hackster254/Water-purifier-LILYGO-Project/WATER PURIFIER LILYGO PCB/12v_5v_IMAGEBACK.png

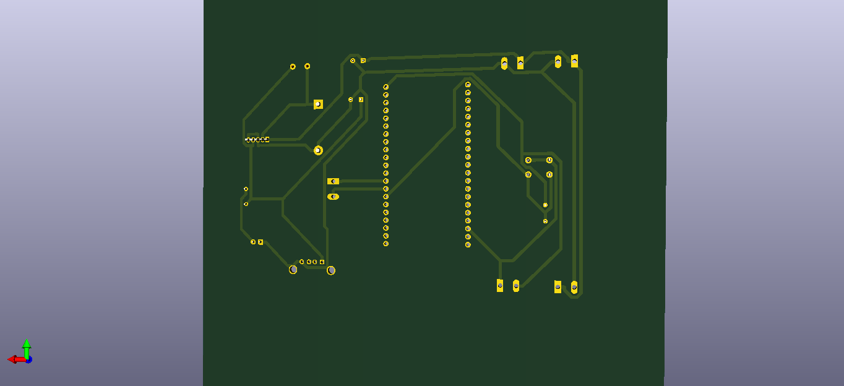
WATER PURIFIER LILYGO PCB/12v_5v_IMAGEBACK.png
