hackster254/Water-purifier-LILYGO-Project/WATER PURIFIER LILYGO PCB/REDITADDEDSCHEMATIC.pdf

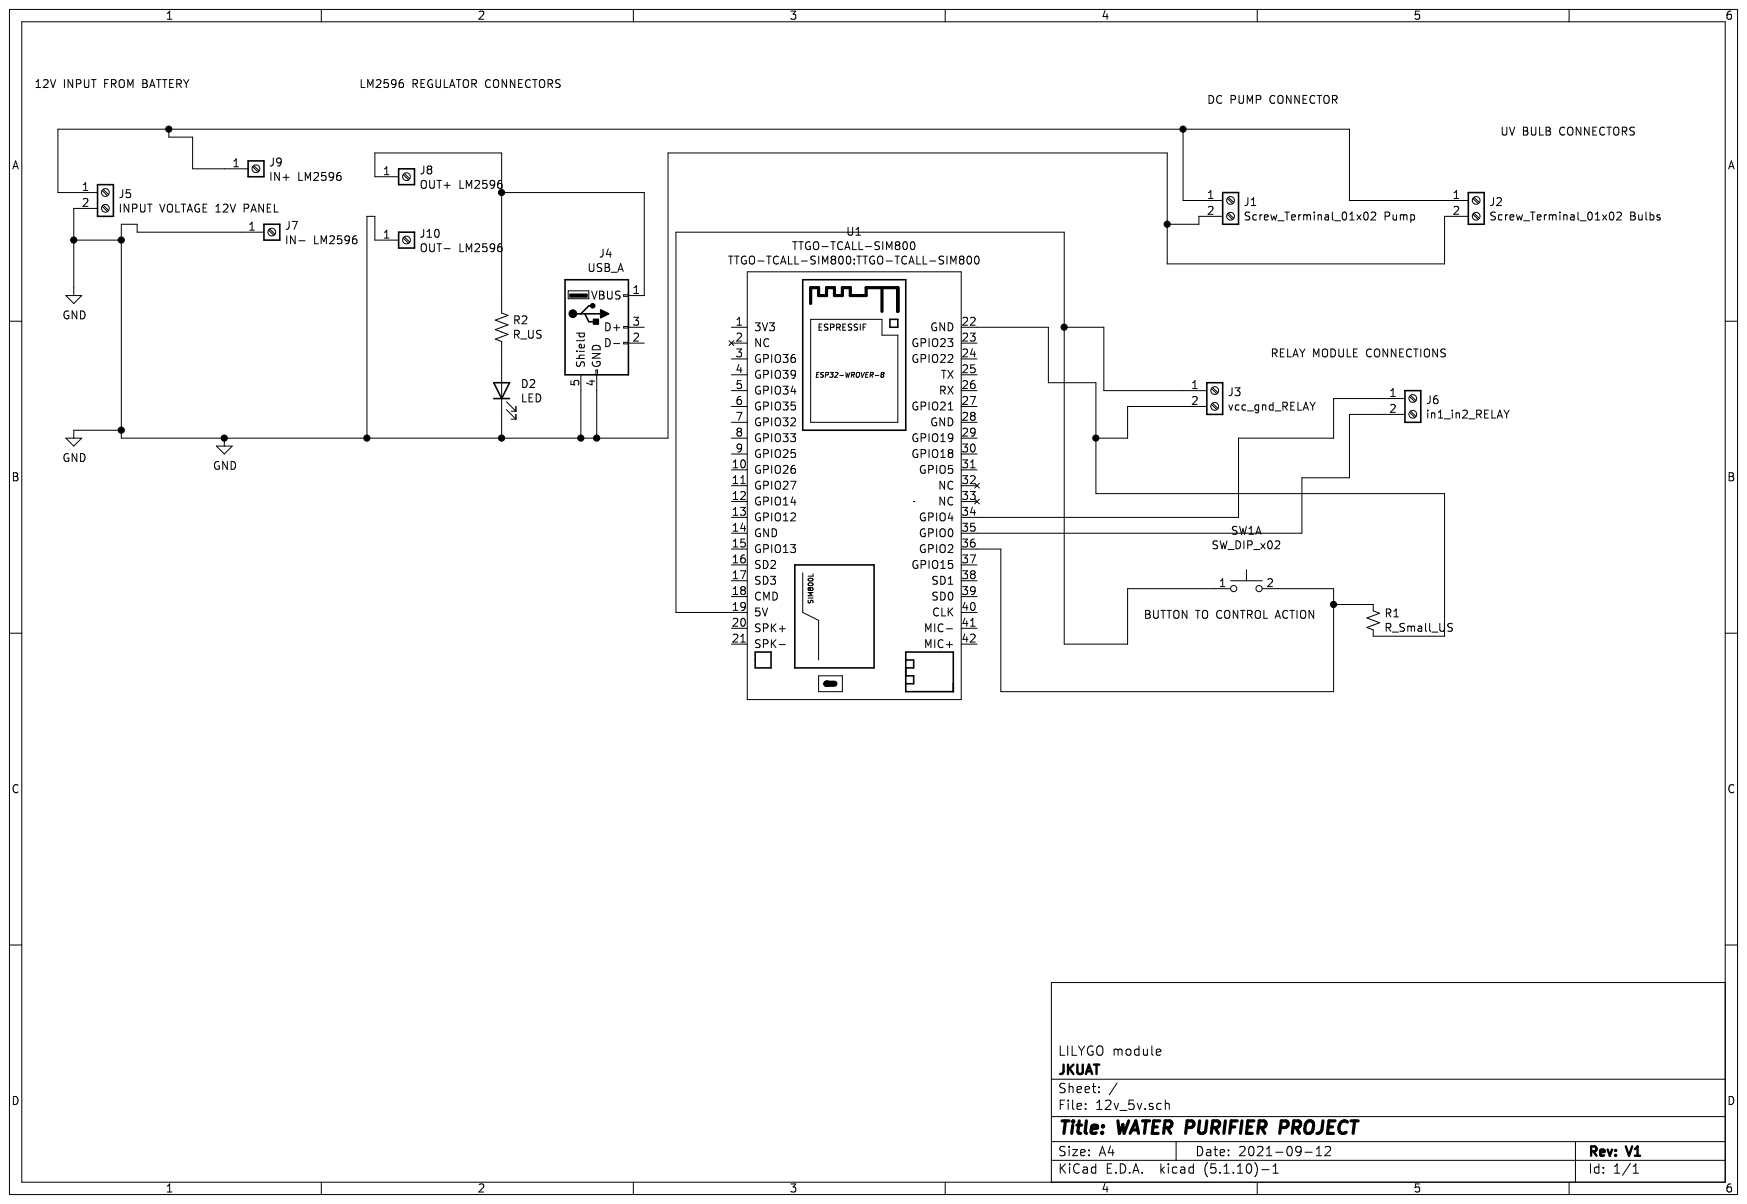
[picture p37: page 1]
