hackster254/Water-purifier-LILYGO-Project/WATER PURIFIER LILYGO PCB/REDITADDEDSINGLEPAGES.pdf

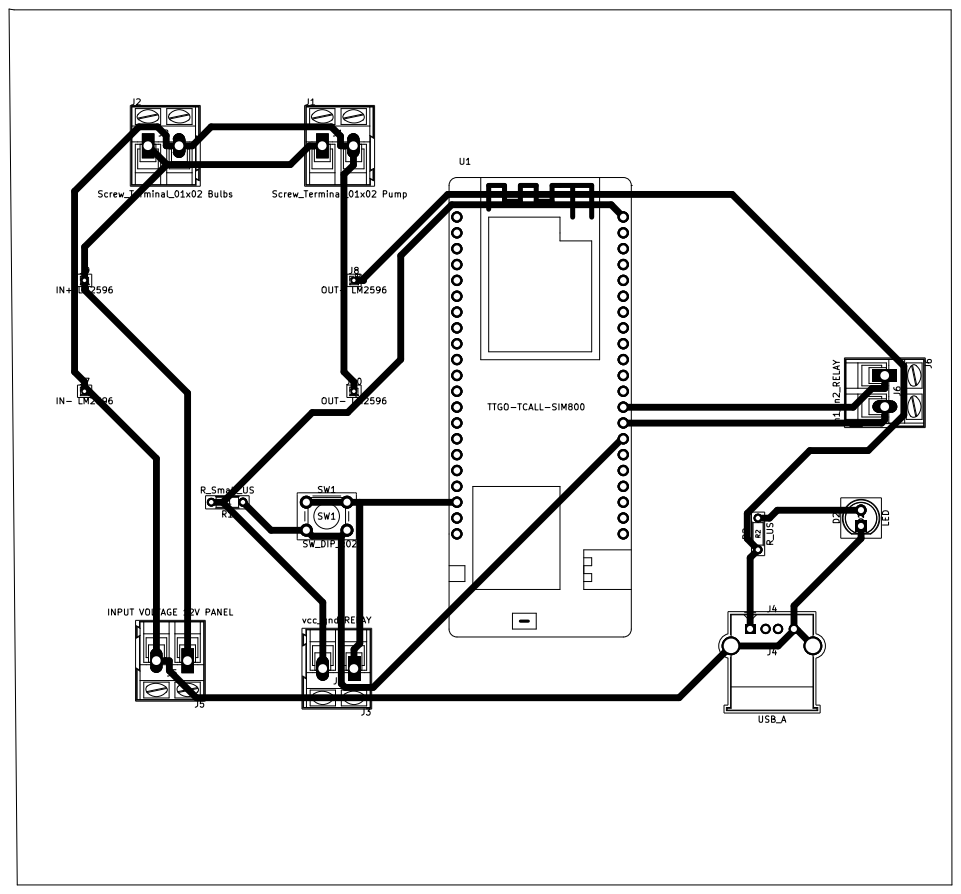
[picture p38: page 1]
