hackster254/Water-purifier-LILYGO-Project/WATER PURIFIER LILYGO PCB/SAM_COMBINEDTRACES.pdf

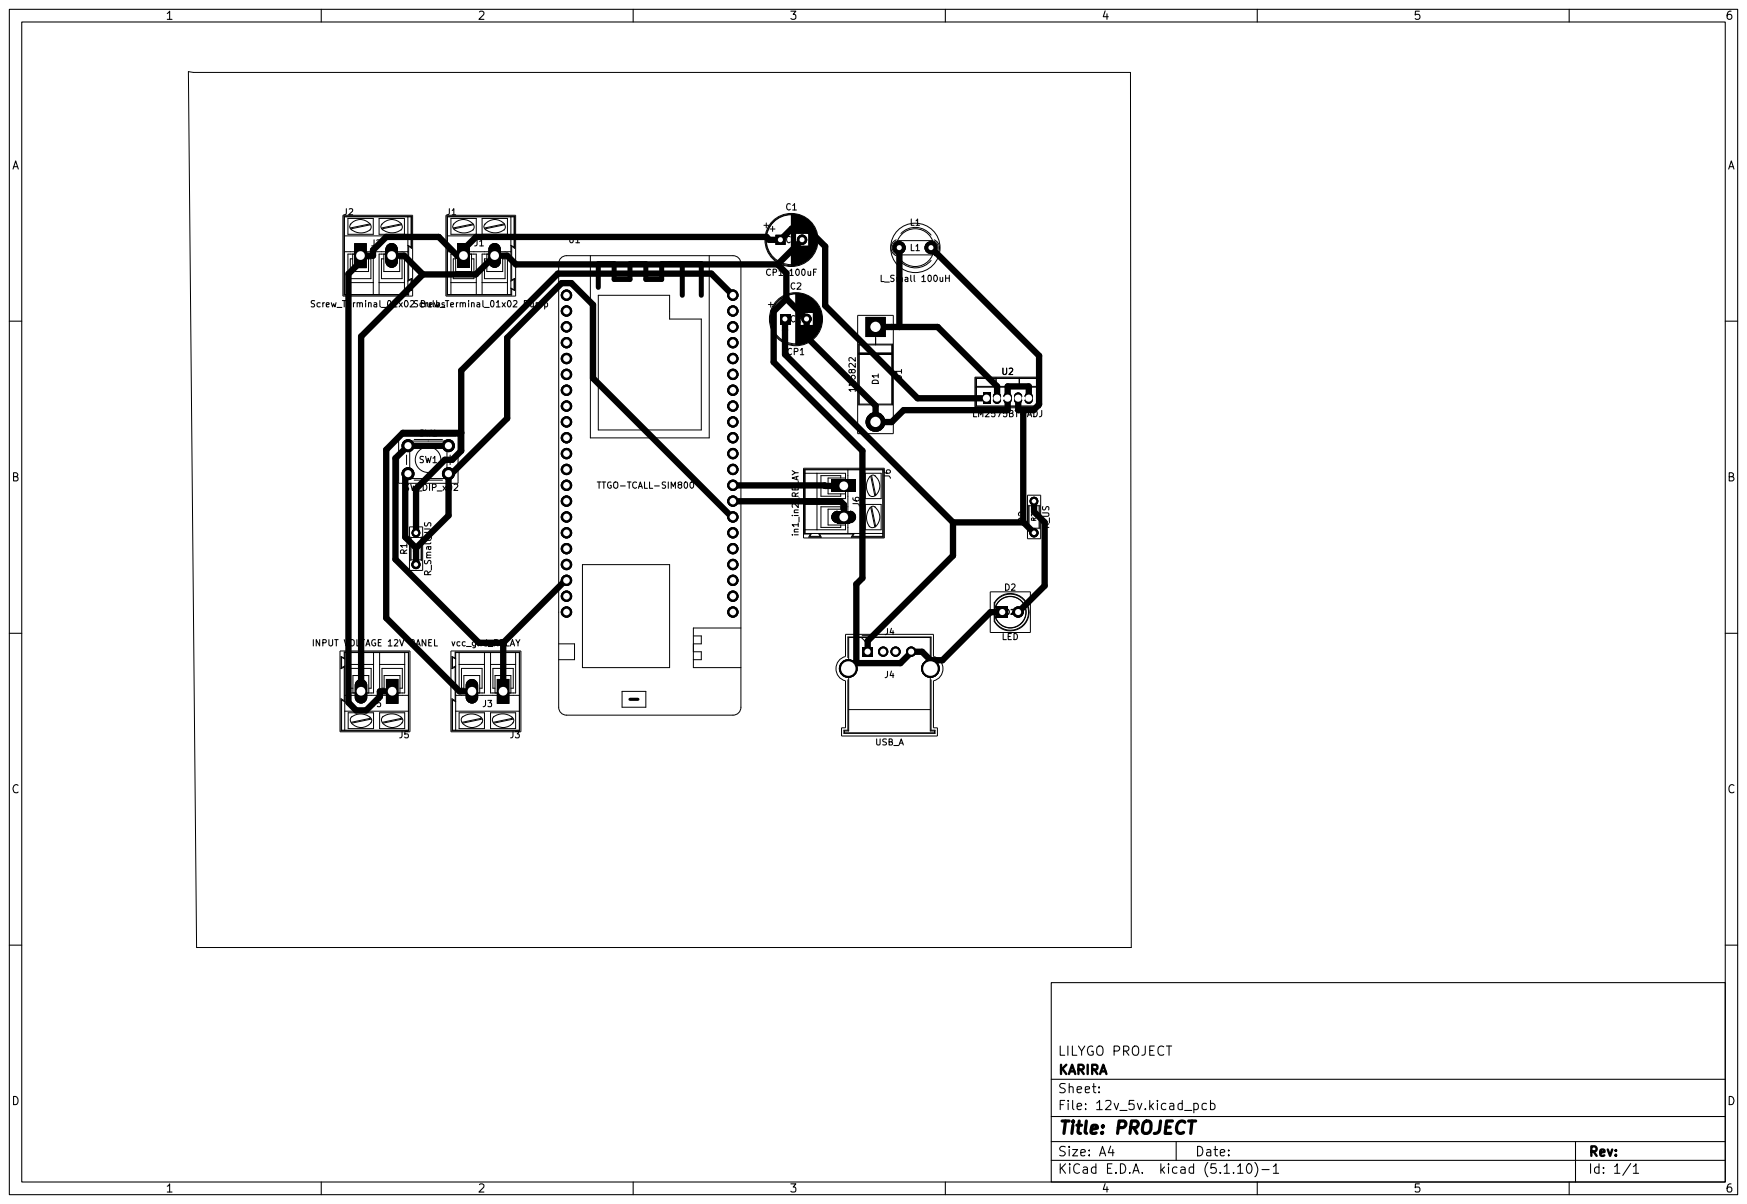
[picture p39: page 1]
