hackster254/Water-purifier-LILYGO-Project/(list of files, drawings)

Other design files:
WATER PURIFIER LILYGO PCB/12v_5v.dsn
WATER PURIFIER LILYGO PCB/12v_5v_EDITEDADDED.dsn
WATER PURIFIER LILYGO PCB/12v_5v_FRIDAY_SAM.dsn
WATER PURIFIER LILYGO PCB/12v_5v_v1.dsn
