hackster254/Water-purifier-LILYGO-Project/WATER PURIFIER LILYGO PCB/12v_5v.kicad_pcb

## KiCad design WATER PURIFIER LILYGO PCB/12v_5v.kicad_pcb (2021-11-19)

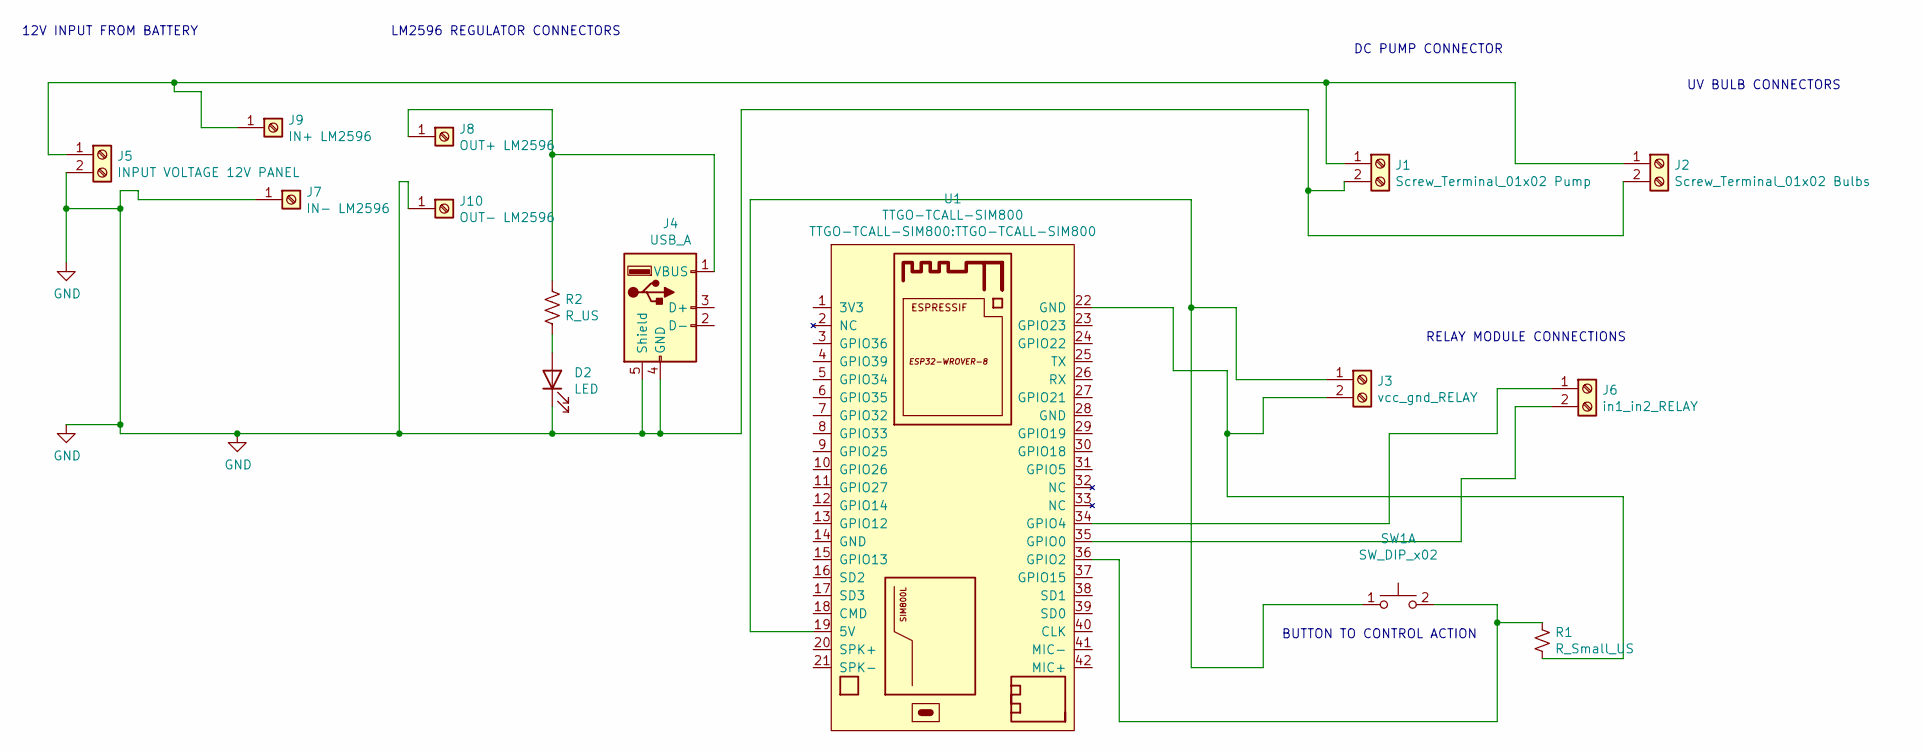
[picture p40: schematic 12v_5v.sch, WATER PURIFIER PROJECT]

Parts:
D2: LED; LED_D5.0mm
J1: Screw_Terminal_01x02 Pump; TerminalBlock_Altech_AK300-2_P5.00mm
J2: Screw_Terminal_01x02 Bulbs; TerminalBlock_Altech_AK300-2_P5.00mm
J3: vcc_gnd_RELAY; TerminalBlock_Altech_AK300-2_P5.00mm
J4: USB_A; USB_A_Molex_67643_Horizontal
J5: INPUT VOLTAGE 12V PANEL; TerminalBlock_Altech_AK300-2_P5.00mm
J6: in1_in2_RELAY; TerminalBlock_Altech_AK300-2_P5.00mm
J7: IN- LM2596; PinHeader_1x01_P1.00mm_Vertical
J8: OUT+ LM2596; PinHeader_1x01_P1.00mm_Vertical
J9: IN+ LM2596; PinHeader_1x01_P1.00mm_Vertical
J10: OUT- LM2596; PinHeader_1x01_P1.00mm_Vertical
R1: R_Small_US; R_Axial_DIN0204_L3.6mm_D1.6mm_P5.08mm_Horizontal
R2: R_US; R_Axial_DIN0204_L3.6mm_D1.6mm_P5.08mm_Horizontal
SW1: SW_DIP_x02; SW_PUSH_6mm_H5mm
U1: TTGO-TCALL-SIM800

Connections:
GND: D2.1 (K), J1.2, J2.2, J4.4 (GND), J4.5 (Shield), J5.2, J7.1, J10.1
unnamed: D2.2 (A), R2.2
unnamed: J1.1, J2.1, J5.1, J9.1
unnamed: J3.1, SW1.1 (C), U1.19 (5V)
unnamed: J3.2, R1.2, U1.22 (GND)
unnamed: J4.1 (VBUS), J8.1, R2.1
unnamed: J6.1, U1.34 (GPIO4)
unnamed: J6.2, U1.35 (GPIO0)
unnamed: R1.1, SW1.2 (D), U1.36 (GPIO2)

Notes on the sheet:
RELAY MODULE CONNECTIONS
UV BULB CONNECTORS
DC PUMP CONNECTOR
12V INPUT FROM BATTERY
BUTTON TO CONTROL ACTION
LM2596 REGULATOR CONNECTORS

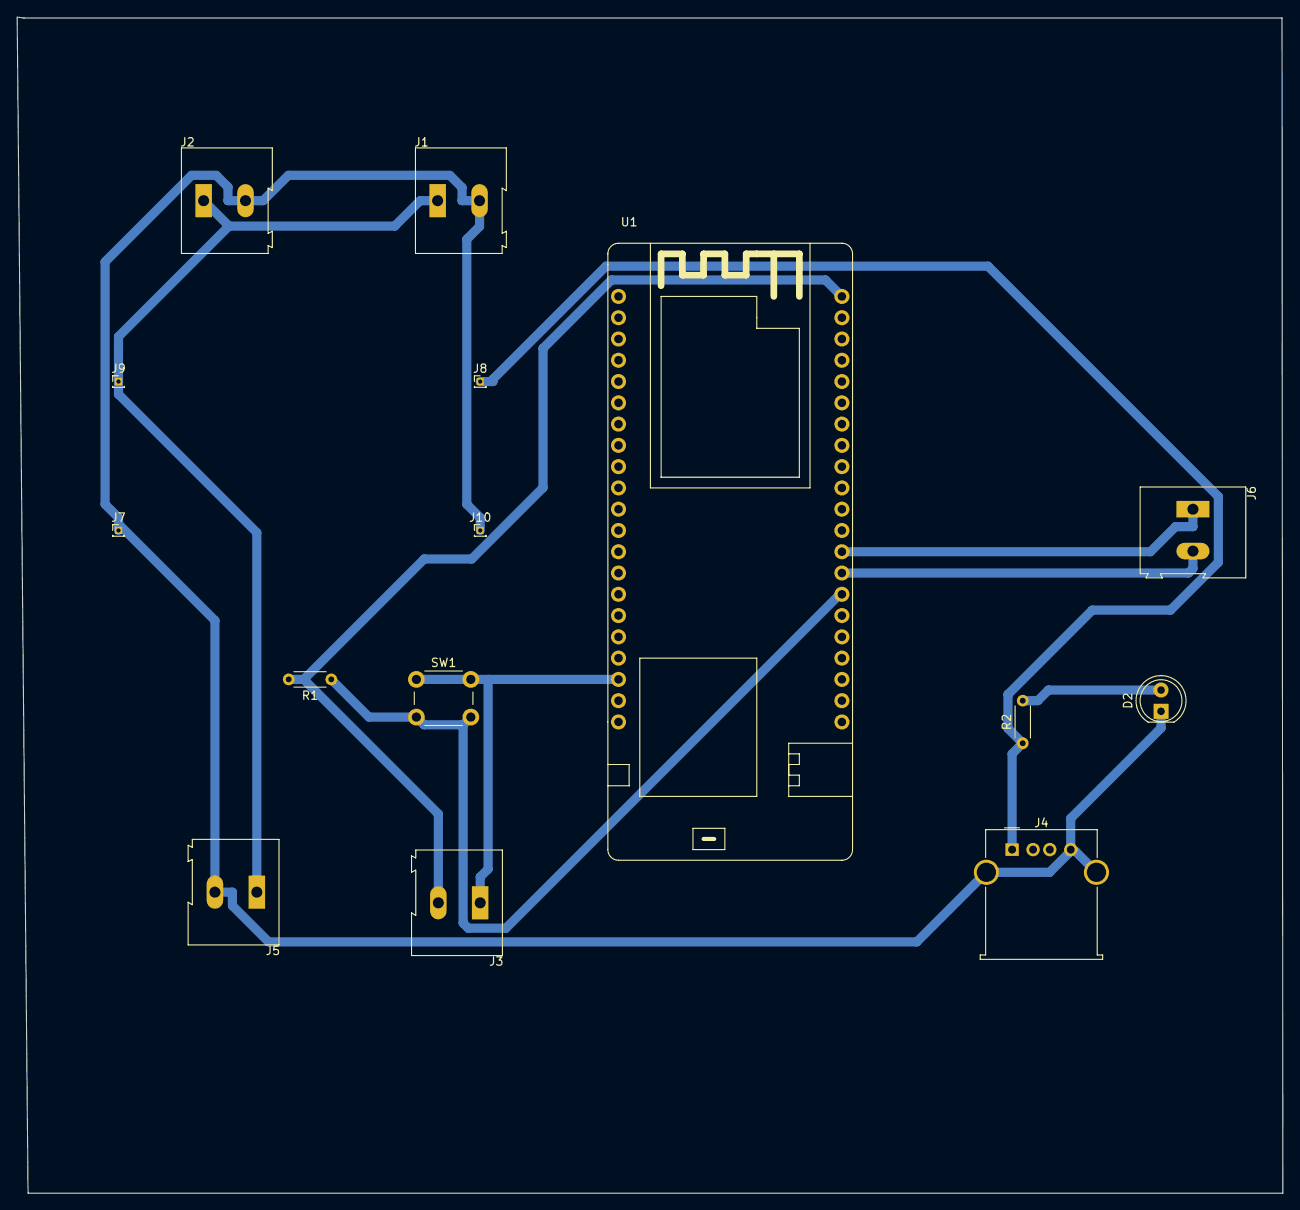
[picture p41: board 12v_5v.kicad_pcb from above]

Board: 2 copper layers, 151.1 x 140.4 mm, 15 parts (0 on the bottom side), 9 nets.
