hackster254/Water-purifier-LILYGO-Project/WATER PURIFIER LILYGO CODE/SMS___Call/secrets.h

// Use this file to store all of the private credentials 
// and connection details

#define SECRET_SSID "TP-Link_F42E"		// replace MySSID with your WiFi network name
#define SECRET_PASS "60298942"	// replace MyPassword with your WiFi password

#define SECRET_CH_ID 1553387			// replace 0000000 with your channel number
#define SECRET_WRITE_APIKEY "0Q0HKOKAV79UBMVE"   // replace XYZ with your channel write API Key

#define SECRET_READ_APIKEY "SUVLVZ0QPFZ03ZNE"  //API Key for Test channel
