hackster254/Water-purifier-LILYGO-Project/(commit log)

2021-11-19 Added PCB kicad schematics
    [12v_5v.dsn, 12v_5v.kicad_pcb, 12v_5v.sch, 12v_5v_EDITEDADDED.dsn, 12v_5v_FRIDAY_SAM.dsn, 12v_5v_v1.dsn]
2021-11-21 Lilygo arduino code
